DariusB04/deskbuddy/step/lid.step

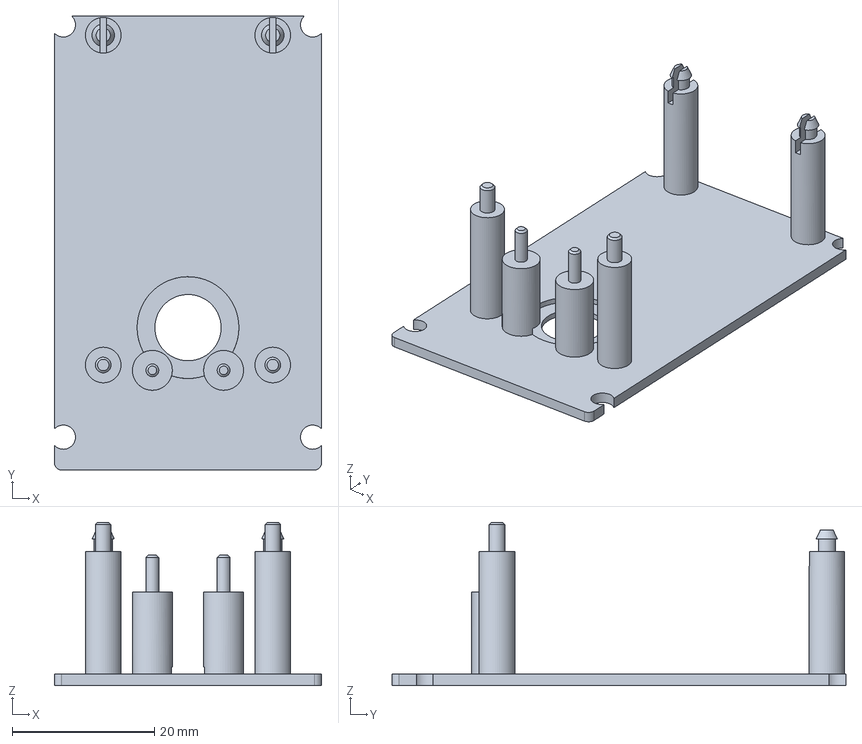
[picture p1: CAD file, 2026-11-12]
step/lid.step
37.5 x 63.7 x 22.9 mm
