DariusB04/deskbuddy/step/v2/oled_clamp.step

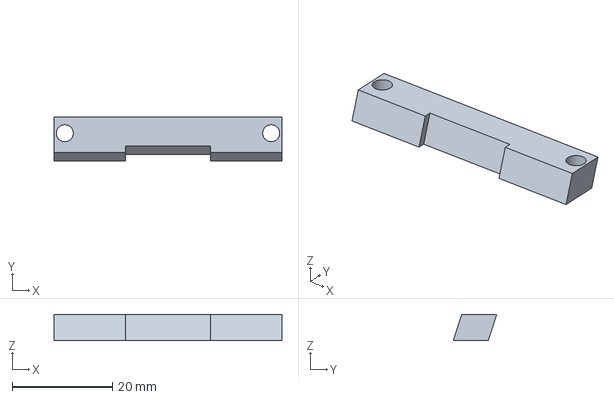
[picture p2: CAD file, 2026-11-13]
step/v2/oled_clamp.step
45.5 x 8.70 x 5.23 mm
