DariusB04/deskbuddy/step/diffuser.step

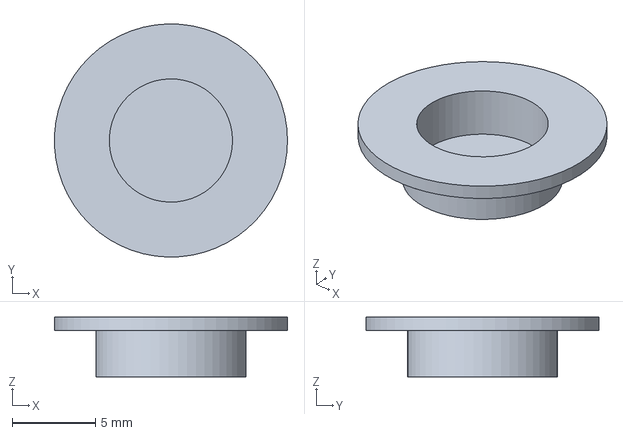
[picture p3: CAD file, 2026-11-12]
step/diffuser.step
14.0 x 14.0 x 3.60 mm
