DariusB04/deskbuddy/step/v2/button_cap.step

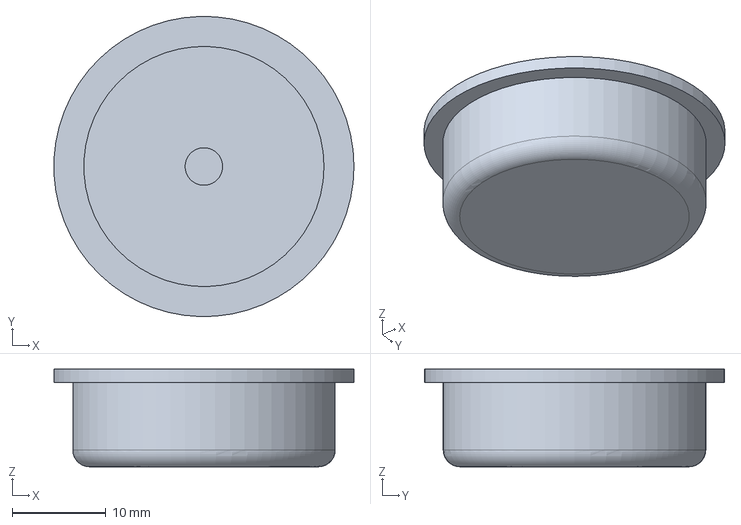
[picture p4: CAD file, 2026-11-13]
step/v2/button_cap.step
32.0 x 32.0 x 10.4 mm
