DariusB04/deskbuddy/step/body.step

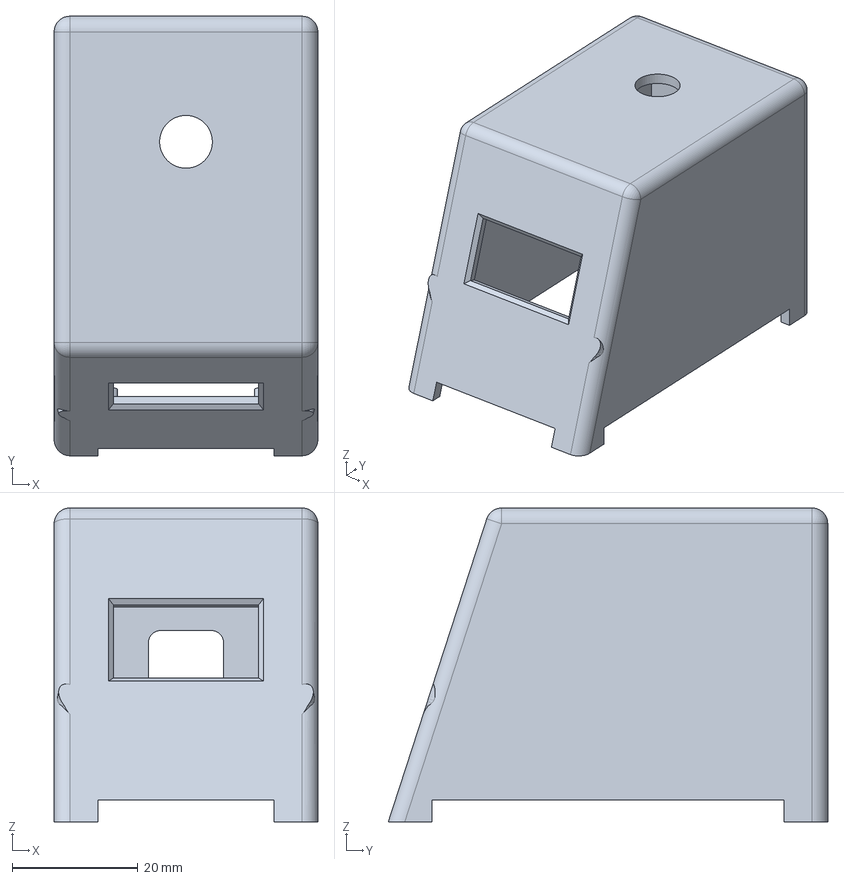
[picture p5: CAD file, 2026-11-12]
step/body.step
42.0 x 70.0 x 50.0 mm
