DariusB04/deskbuddy/step/v2/button_mount.step

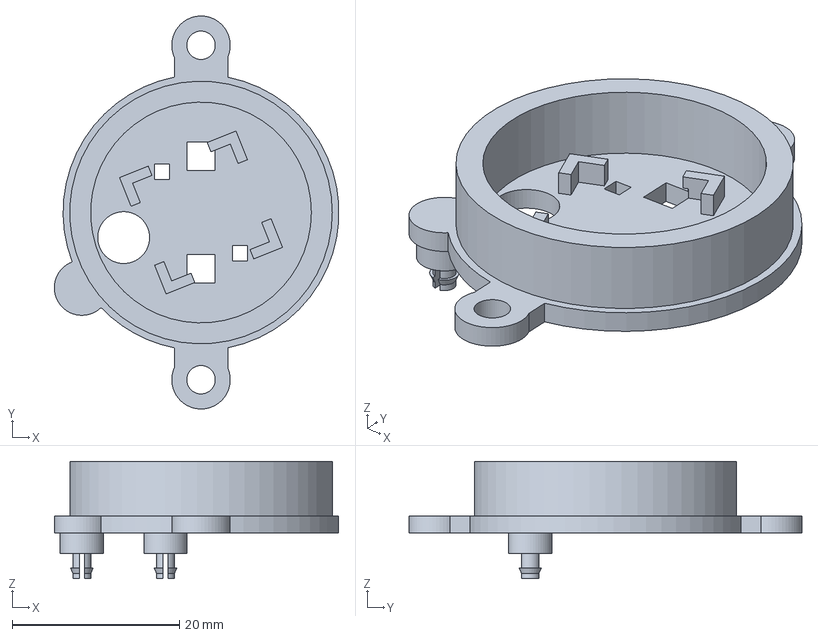
[picture p6: CAD file, 2026-11-13]
step/v2/button_mount.step
34.0 x 47.0 x 14.1 mm
