DariusB04/deskbuddy/step/button_cap.step

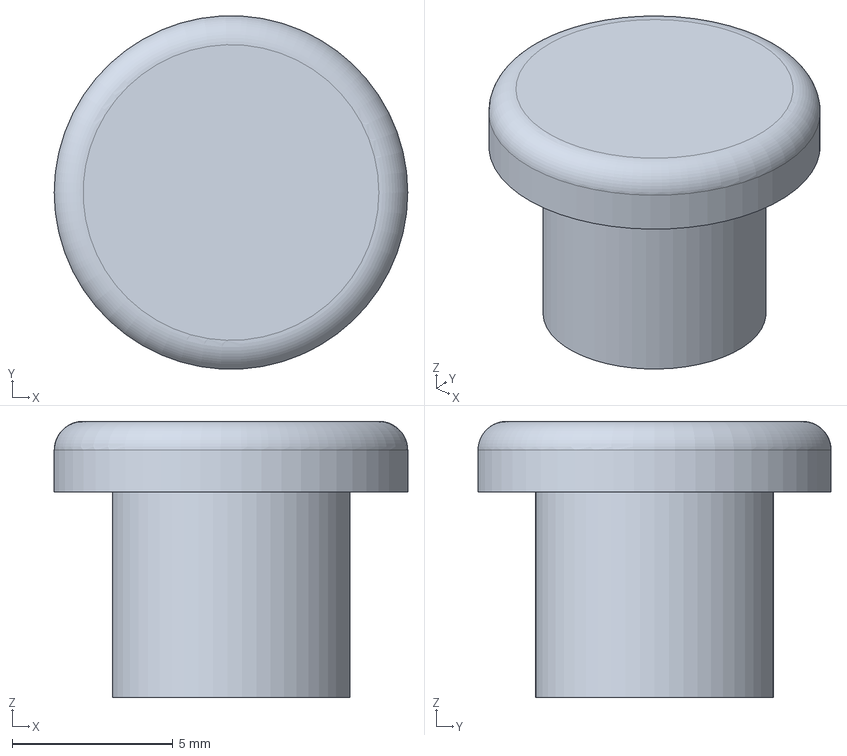
[picture p7: CAD file, 2026-11-12]
step/button_cap.step
11.0 x 11.0 x 8.60 mm
