DariusB04/deskbuddy/step/v2/body.step

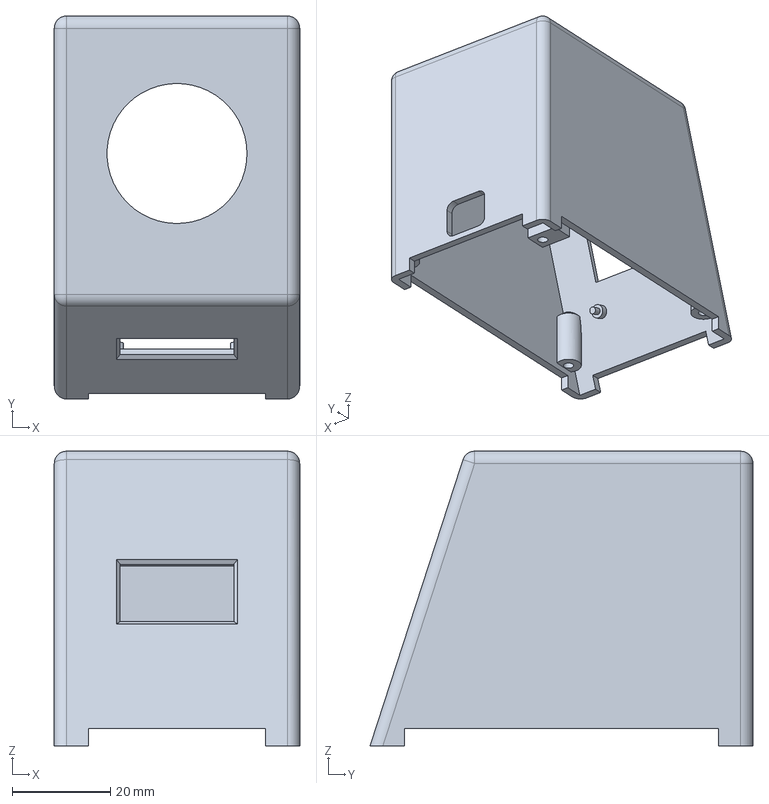
[picture p8: CAD file, 2026-11-13]
step/v2/body.step
50.0 x 78.0 x 60.0 mm
