DariusB04/deskbuddy/step/oled_clamp.step

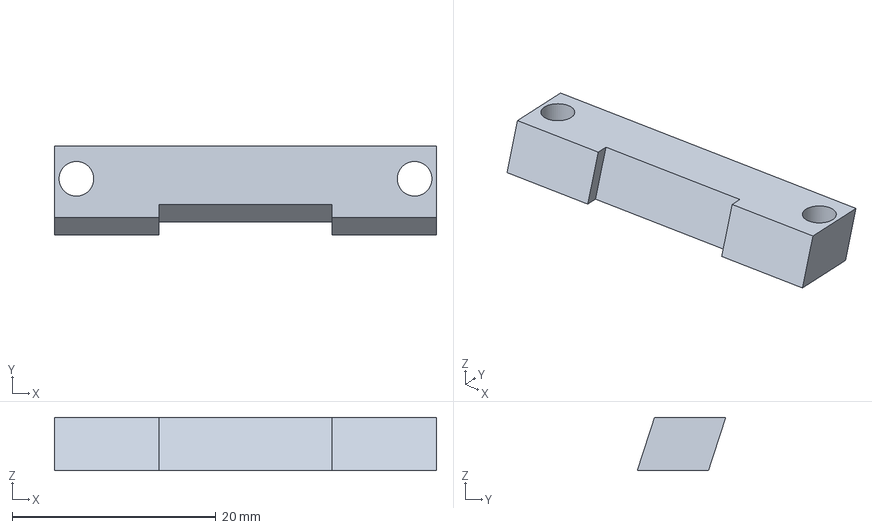
[picture p9: CAD file, 2026-11-12]
step/oled_clamp.step
37.5 x 8.70 x 5.23 mm
