DariusB04/deskbuddy/step/v2/lid.step

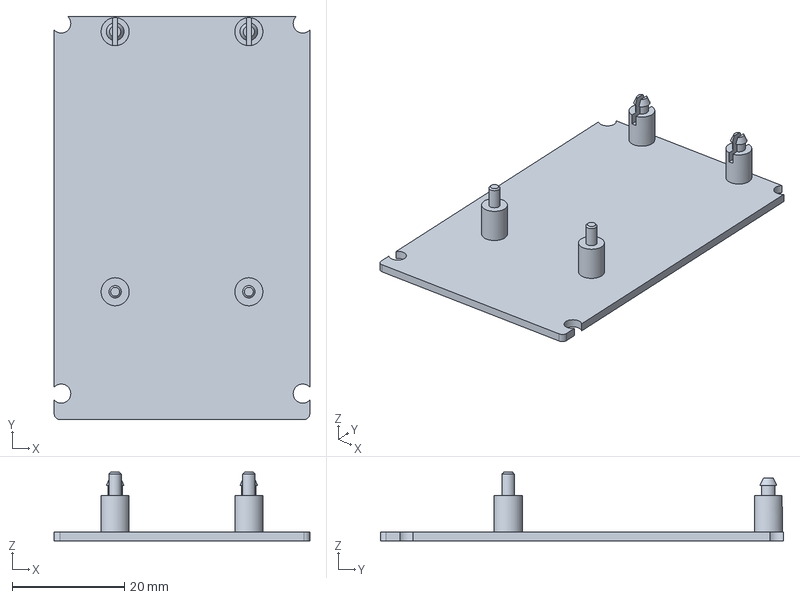
[picture p10: CAD file, 2026-11-13]
step/v2/lid.step
45.5 x 71.7 x 12.2 mm
