DariusB04/deskbuddy/step/fit_test.step

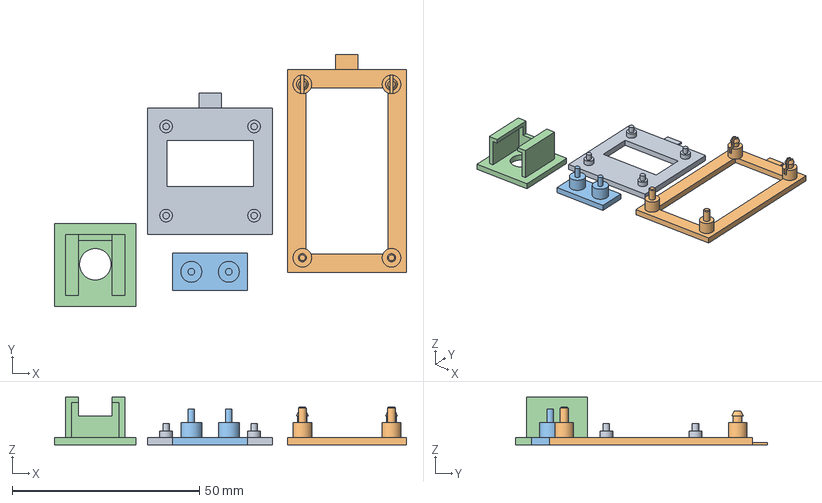
[picture p11: CAD file, 2026-11-12]
step/fit_test.step
94.0 x 67.3 x 12.7 mm
