DariusB04/deskbuddy/step/v2/fit_test_button.step

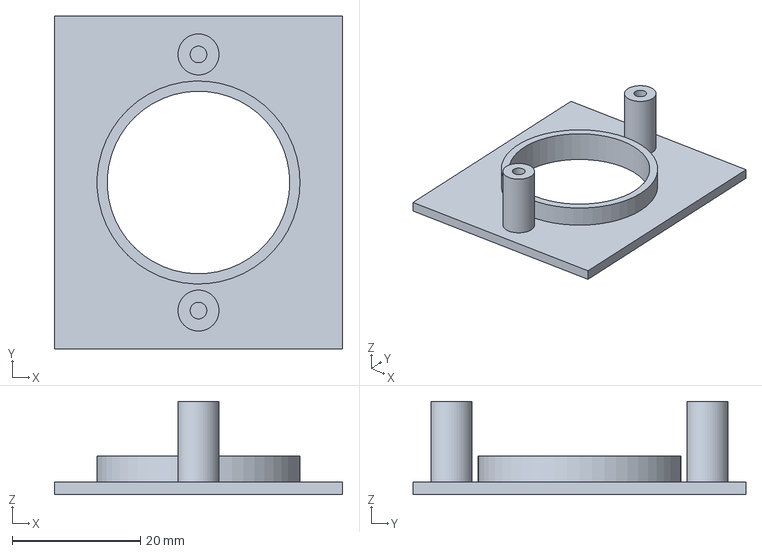
[picture p12: CAD file, 2026-11-13]
step/v2/fit_test_button.step
45.0 x 52.0 x 14.6 mm
