DariusB04/deskbuddy/step/fit_test_esp_led.step

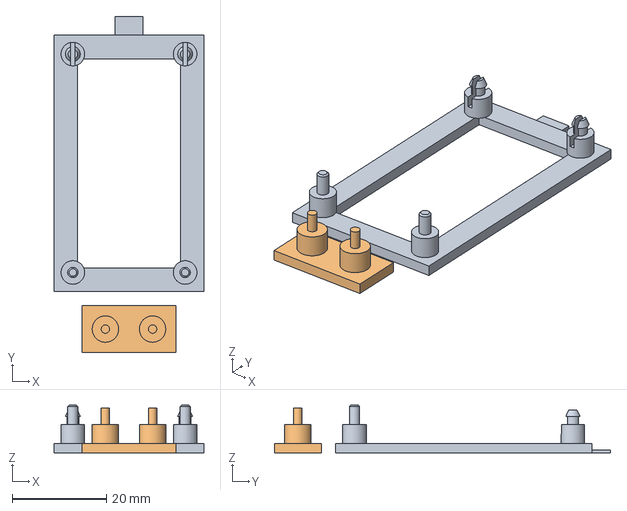
[picture p13: CAD file, 2026-11-12]
step/fit_test_esp_led.step
31.8 x 71.3 x 10.1 mm
