DariusB04/deskbuddy/(list of files, cad)

Other CAD files:
stl/body.stl
stl/button_cap.stl
stl/diffuser.stl
stl/fit_test.stl
stl/fit_test_esp_led.stl
stl/lid.stl
stl/oled_clamp.stl
stl/v2/body.stl
stl/v2/button_cap.stl
stl/v2/button_mount.stl
stl/v2/fit_test_button.stl
stl/v2/lid.stl
stl/v2/oled_clamp.stl
