DariusB04/deskbuddy/(commit log)

2026-11-12 Actualizare v1.1.0
    [body.step, body.stl, button_cap.step, button_cap.stl, cap_placed.stl, diffuser.step, diffuser.stl, esp32.stl]
2026-11-12 Actualizare main
    [cap_placed.stl, esp32.stl, led.stl, oled.stl, oled_view.stl, switch.stl]
